Anodynous/hillside/hillside46-AnodyneZMK/doc/image/hill46_keys.png

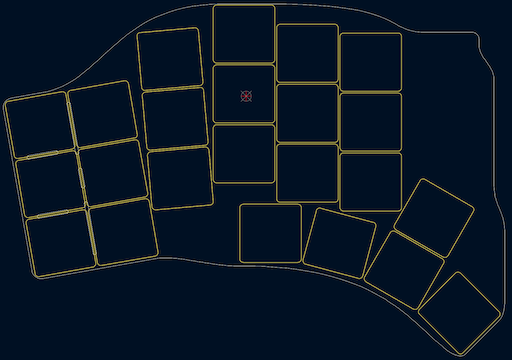
hillside46-AnodyneZMK/doc/image/hill46_keys.png
