Anodynous/hillside/hillside46-AnodyneZMK/hillside46.kicad_pcb

## KiCad design hillside46-AnodyneZMK/hillside46.kicad_pcb (2026-02-02)

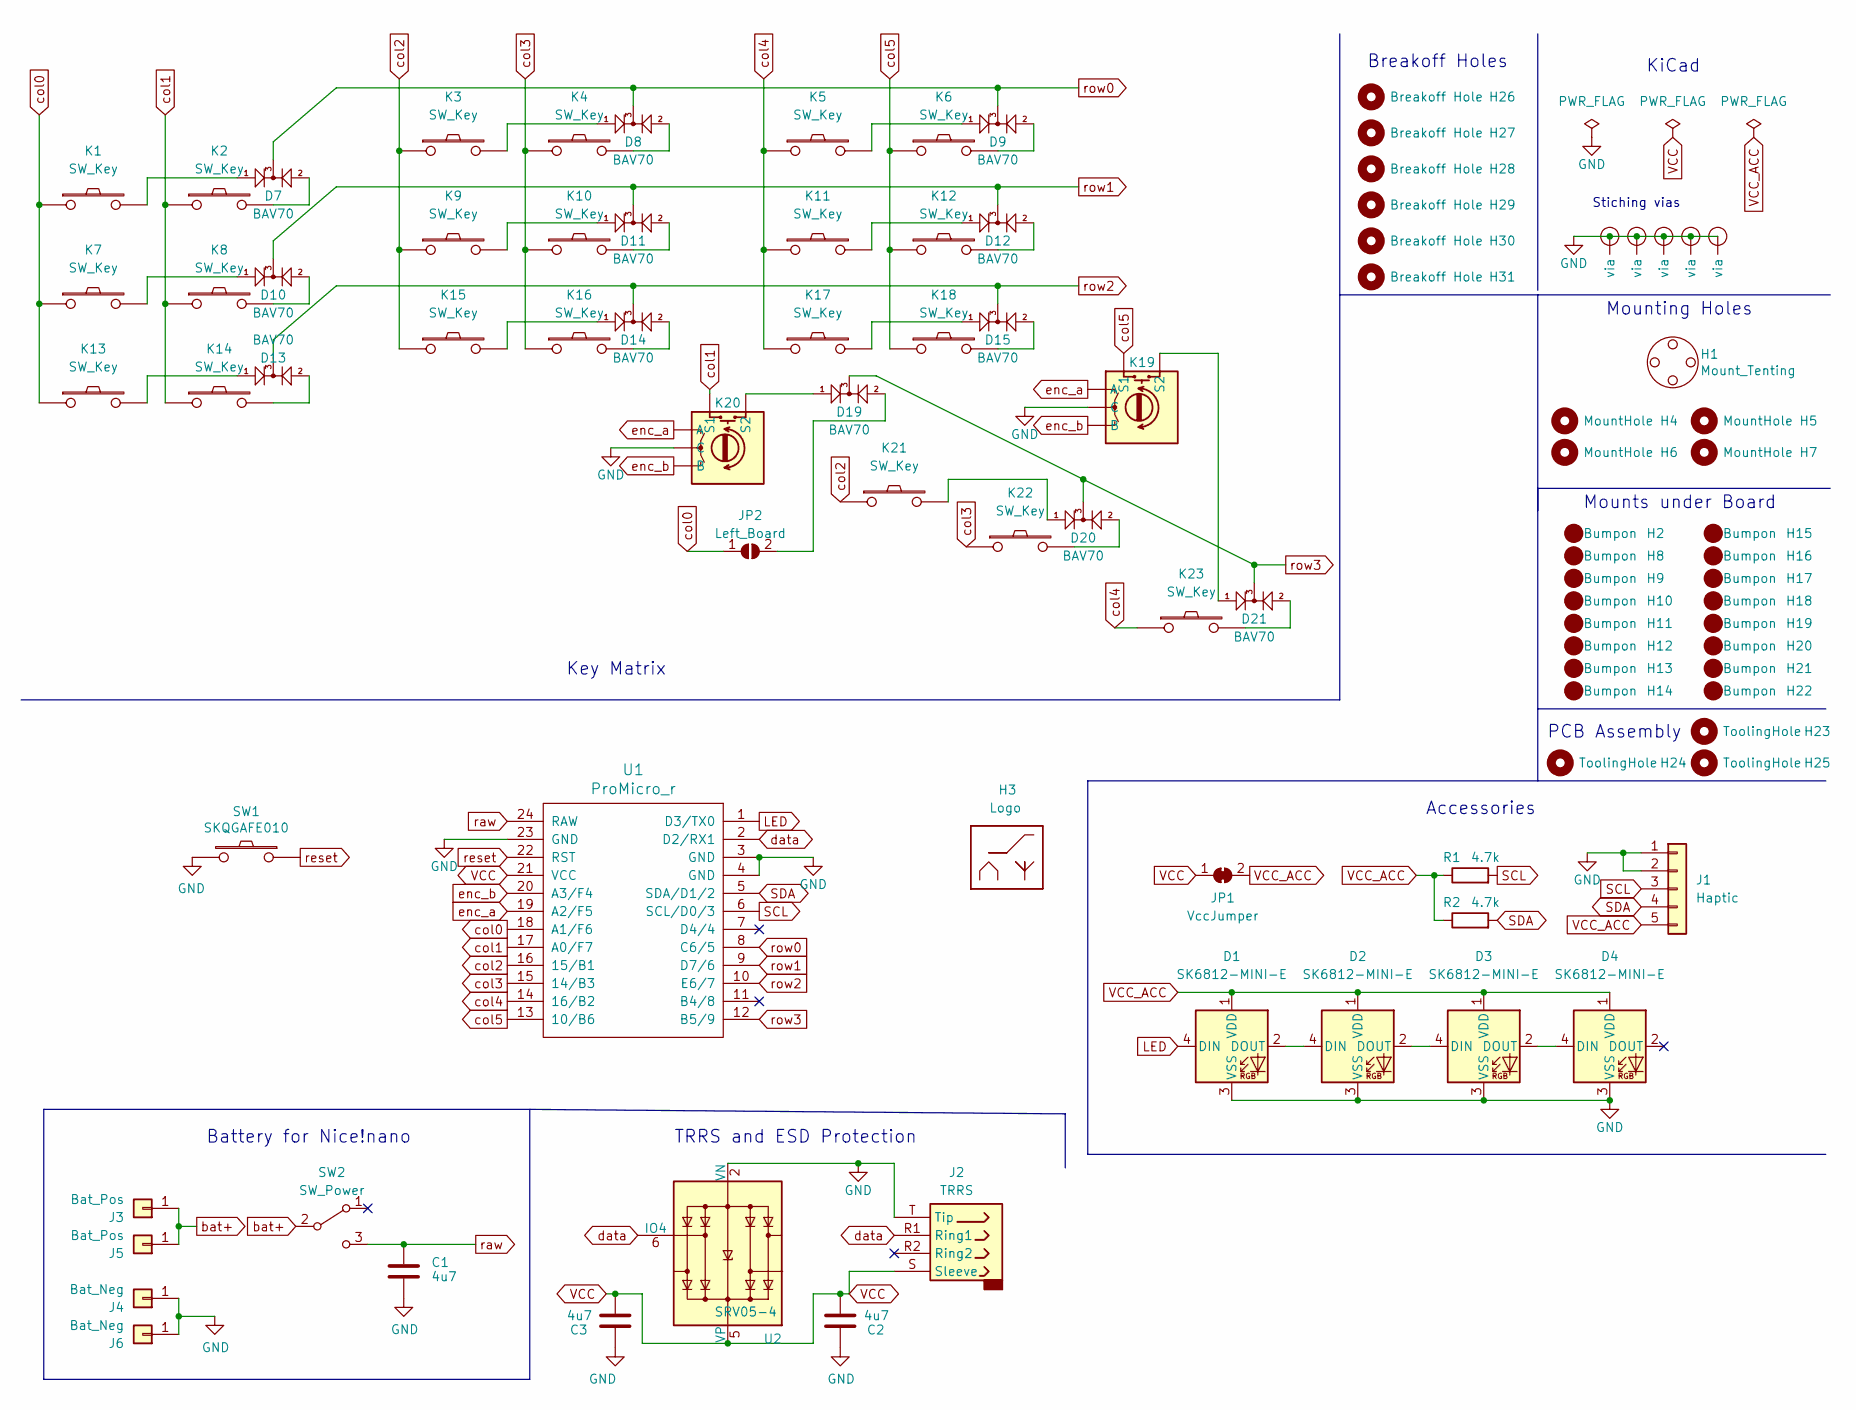
[picture p4: schematic hillside46.kicad_sch, Hillside 46 Keyboard]

Parts:
C1, C2, C3: 4u7; C_0805_2012Metric; JLC Type Basic
D1, D2, D3, D4: SK6812-MINI-E
D7, D8, D9, D10, D11, D12, D13, D14, D15, D19, D20, D21: BAV70; SOT-23; LCSC C68978
H1: Mount_Tenting; Tenting_Puck
H2, H8, H9, H10, H11, H12, H13, H14, H15, H16, H17, H18, H19, H20, H21, H22: Bumpon
H3: Logo; Hillside_Logo
H4, H5, H6, H7: MountHole; MountingHole_2.2mm_with_PCB_insert_rings
H23, H24, H25: ToolingHole; ToolingHole_1.152mm
H26, H27, H28, H29, H30, H31: Breakoff Hole; HoleBreakoff_1mm
J1: Haptic; Pimoroni_Haptic
J2: TRRS; MJ-4PP-9
J3, J5: Bat_Pos; 1pin_conn
J4, J6: Bat_Neg; 1pin_conn
JP1: VccJumper; SolderJumper-2_P1.3mm_Bridged_RoundedPad1.0x1.5mm
JP2: Left_Board; SolderJumper-2_P1.3mm_Open_TrianglePad1.0x1.5mm
K1, K2, K3, K4, K5, K6, K7, K8, K9, K10, K11, K12, K13, K14, K15, K16, K17, K18, K21, K22, K23: SW_Key; pg1350-R_hotswap
K19, K20: SW_Rotary; pg1350-DR_rotary_hotswap
R1, R2: 4.7k; R_0805_2012Metric; LCSC C17673
SW1: SKQGAFE010; SW_SPST_SKQG_WithStem; LCSC C318884
SW2: SW_Power; SW_SPDT_JS202011AQN; JLC Type Extended part for Standard PCBA only
U1: ProMicro_r; ProMicro_v2
U2: SRV05-4; SOT-23-6_Handsoldering_threenumbered; JLC Type Basic
V1, V2, V3, V4, V5: Via; VIA-0.8mm

Connections:
GND: C1.2, C2.1, C3.1, D1.3 (VSS), D2.3 (VSS), D3.3 (VSS), D4.3 (VSS), J1.1, J1.2, J2.T (Tip), J4.1, J6.1, K19.C, K20.C, SW1.2, U1.3 (GND), U1.4 (GND), U1.23 (GND), U2.2 (VN), V1.1 (via), V2.1 (via), V3.1 (via), V4.1 (via), V5.1 (via)
LED: D1.4 (DIN), U1.1 (D3/TX0)
unnamed: D1.2 (DOUT), D2.4 (DIN)
unnamed: D2.2 (DOUT), D3.4 (DIN)
unnamed: D3.2 (DOUT), D4.4 (DIN)
unnamed: D7.1 (A1), K1.2
unnamed: D7.2 (A2), K2.2
unnamed: D8.1 (A1), K3.2
unnamed: D8.2 (A2), K4.2
unnamed: D9.1 (A1), K5.2
unnamed: D9.2 (A2), K6.2
unnamed: D10.1 (A1), K7.2
unnamed: D10.2 (A2), K8.2
unnamed: D11.1 (A1), K9.2
unnamed: D11.2 (A2), K10.2
unnamed: D12.1 (A1), K11.2
unnamed: D12.2 (A2), K12.2
unnamed: D13.1 (A1), K13.2
unnamed: D13.2 (A2), K14.2
unnamed: D14.1 (A1), K15.2
unnamed: D14.2 (A2), K16.2
unnamed: D15.1 (A1), K17.2
unnamed: D15.2 (A2), K18.2
unnamed: D19.1 (A1), K20.S2
unnamed: D19.2 (A2), JP2.2 (B)
unnamed: D20.1 (A1), K21.2
unnamed: D20.2 (A2), K22.2
unnamed: D21.1 (A1), K19.S2
unnamed: D21.2 (A2), K23.2
SCL: J1.3, R1.2, U1.6 (SCL/D0/3)
SDA: J1.4, R2.2, U1.5 (SDA/D1/2)
VCC: C2.2, C3.2, J2.S (Sleeve), JP1.1 (A), U1.21 (VCC), U2.5 (VP)
VCC_ACC: D1.1 (VDD), D2.1 (VDD), D3.1 (VDD), D4.1 (VDD), J1.5, JP1.2 (B), R1.1, R2.1
bat+: J3.1, J5.1, SW2.2 (B)
col0: JP2.1 (A), K1.1, K7.1, K13.1, U1.18 (A1/F6)
col1: K2.1, K8.1, K14.1, K20.S1, U1.17 (A0/F7)
col2: K3.1, K9.1, K15.1, K21.1, U1.16 (15/B1)
col3: K4.1, K10.1, K16.1, K22.1, U1.15 (14/B3)
col4: K5.1, K11.1, K17.1, K23.1, U1.14 (16/B2)
col5: K6.1, K12.1, K18.1, K19.S1, U1.13 (10/B6)
data: J2.R1 (Ring1), U1.2 (D2/RX1), U2.6 (IO4)
enc_a: K19.A, K20.A, U1.19 (A2/F5)
enc_b: K19.B, K20.B, U1.20 (A3/F4)
raw: C1.1, SW2.3 (C), U1.24 (RAW)
reset: SW1.1, U1.22 (RST)
row0: D7.3 (K), D8.3 (K), D9.3 (K), U1.8 (C6/5)
row1: D10.3 (K), D11.3 (K), D12.3 (K), U1.9 (D7/6)
row2: D13.3 (K), D14.3 (K), D15.3 (K), U1.10 (E6/7)
row3: D19.3 (K), D20.3 (K), D21.3 (K), U1.12 (B5/9)

Notes on the sheet:
KiCad
Mounting Holes
Key Matrix
Battery for Nice!nano
TRRS and ESD Protection
PCB Assembly
Stiching vias
Breakoff Holes
Mounts under Board
Accessories

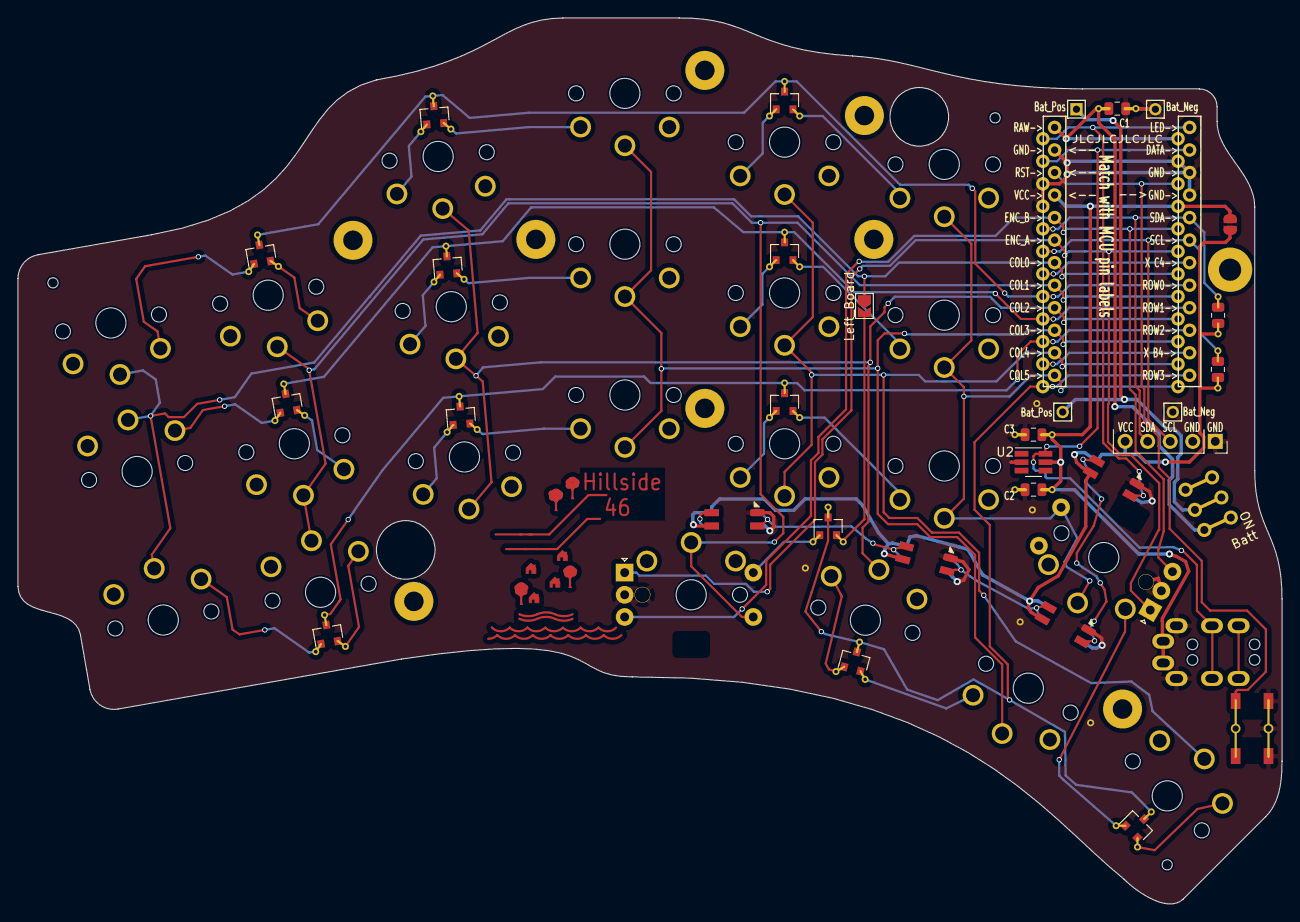
[picture p5: board hillside46.kicad_pcb from above]

Board: 2 copper layers, 142.5 x 99.9 mm, 86 parts (0 on the bottom side), 49 nets.
