Anodynous/hillside/hillside46-AnodyneZMK/doc/changelog.md

# Version 0.1.0

The initial Hillside 46 release.

Key differences from the Hillside 48:

- 46 keys, removing the extra key under the ring column.
- Splay of five and ten degrees for the ring and pinkie columns.
- PCBA for diodes and other SMT, except LEDs
- Two spots for one encoder per side.
- Hotswap switch option using Mill-Max sockets.

Key differences from the Hillside 52:

- No bottom utility/arrow row
- PCBA
