Anodynous/hillside/(commit log)

2026-02-02 create hillside46-AnodyneZMK
    [hillside46.kicad_pcb, hillside46.kicad_sch]
2026-02-02 upgrade kicad file version
    [hillside46.kicad_pcb]
2026-02-02 remove pinkie column cutouts
    [hillside46.kicad_pcb]
2026-02-02 clean up silkscreen
    [hillside46.kicad_pcb]
2026-02-02 cut VccJumper trace for wireless
    [hillside46.kicad_pcb]
2026-02-02 remove puck silkscreen circle
    [hillside46.kicad_pcb]
2026-02-02 remove LED cut-outs
    [hillside46.kicad_pcb]
2026-02-02 refill zones and perform DRC
    [hillside46.kicad_pcb]
2026-02-02 exclude invalid DRC errors, generate gerber files
    [hillside46.kicad_pcb]
